solarbits/wsp-solar2020/docs/photos/wotton-swimming-pool.jpg

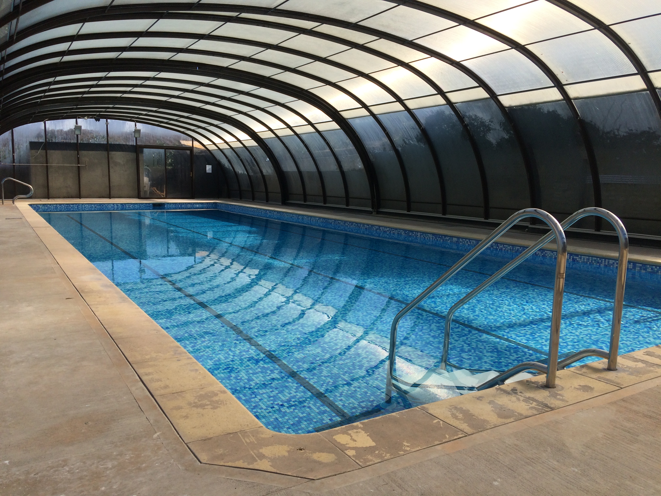
docs/photos/wotton-swimming-pool.jpg
