solarbits/wsp-solar2020/docs/photos/pumps-and-valves-layout.jpg

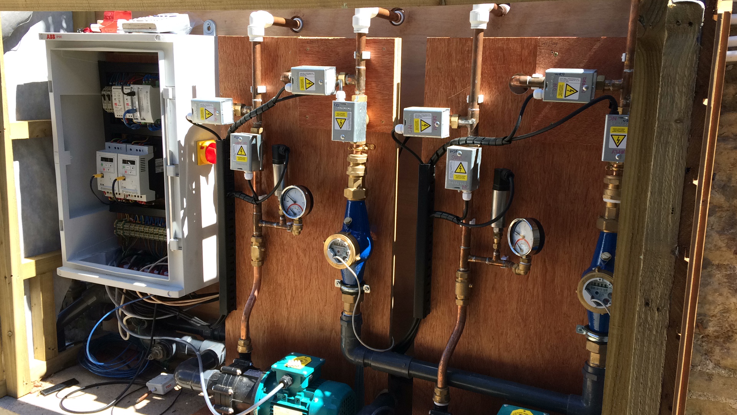
docs/photos/pumps-and-valves-layout.jpg
