solarbits/wsp-solar2020/node-red/README.md

# Node-RED flows

Flow exports for the remote monitoring dashboard. Import them through the
Node-RED editor (Menu → Import). They are exports, not a deployed
configuration — the running instance is the source of truth.

FLows and deployment details for node red are now version controlled at: https://github.com/errkk/wsp-node-red

| File | Notes |
| --- | --- |
| `2021-03-03_dashboard-flow.json` | Full dashboard: MQTT input, JSON parsing, routing by `zone`/`index`, charts, gauges and Pushover alerts (87 nodes). |
| `2021-01-03_chart-node-export.json` | Partial export — a single east-panel temperature chart node. Superseded by the file above. |

## Wire format

The PLC publishes each value individually to topic `IP65`:

```json
{ "zone": 0, "index": 4, "value": 285 }
```

`zone` selects the kind of reading and `index` selects which one within that
kind, matching the `INDEX_*` constants in the sketch.

| zone | Contents | Units |
| ---- | --- | --- |
| 0 | Sensor readings (9) | temperatures in tenths of °C, pressures in millibars |
| 1 | Pump states (2) | 0 = off, 1 = on |
| 2 | Roof states (2) | 0 low pressure, 1 pool too hot, 2 cool roof, 3 heat pool, 4 await sunshine |
| 3 | Roof powers (2) | decawatts |
| 4 | *Not published* | Was chemistry (0 = pH ×100, 1 = chlorine in hundredths of ppm). The PLC no longer sends it: chemistry is read directly from the doser by node red over modbus TCP over a VPN. So this part of the payload could be repurposed. |
| 5 | Flow rates (2) | 0 = west panel, 1 = east panel, in tenths of a litre per minute (`200` = 20 L/min). From the flow meters on I0.0/I0.1; 0 when stopped. |

Changing the zone/index numbering or the topic in the sketch breaks these flows.
