solarbits/wsp-solar2020/docs/diagrams/software-architecture_2021-04-28_with-chemistry.pdf

MODBUS MANAGER
Every few 10s of mS read a sensor (or instruct a pump) and increment the counter to the next modbus address, swapping read/write after each population serviced.
Every cycle check whether MQTT is connected ok, and if not reconnect.

Any modbus
responses?
listenForResponse() | Yes

machine loop

every few uS

pop it into the right place in the results array: handleResponseData(addr,value)
(if it was a pressure convert value to integer format first) convert32BitFloatToInt(value)
requestNextRead() and increment address pointer | requestReadFrom(addr,value)
requestNextWrite() and increment address pointer | requestWriteFor(pump1/2, on/off)

DEAL WITH DATA
sensorReadings[0,1,2,3,4,5,6,7,8] Every few seconds look at the data array, decide what needs doing (decisionTree()). Also read pH and chlorine data from two analogue inputs (readChemistry()). Then send the data, the pump state and the roof operational state to Node Red via MQTT

switchWestOff()
switchEastOff()
coolWestRoof()
coolEastRoof()
heatPoolFromWest()
heatPoolFromEast()

Switch pumps on/off (using the write queue) and control the 8 motorised valve relays with

digitalWrite(RelayNo, on/off)

No
