solarbits/wsp-solar2020/docs/photos/electrical-enclosure.jpg

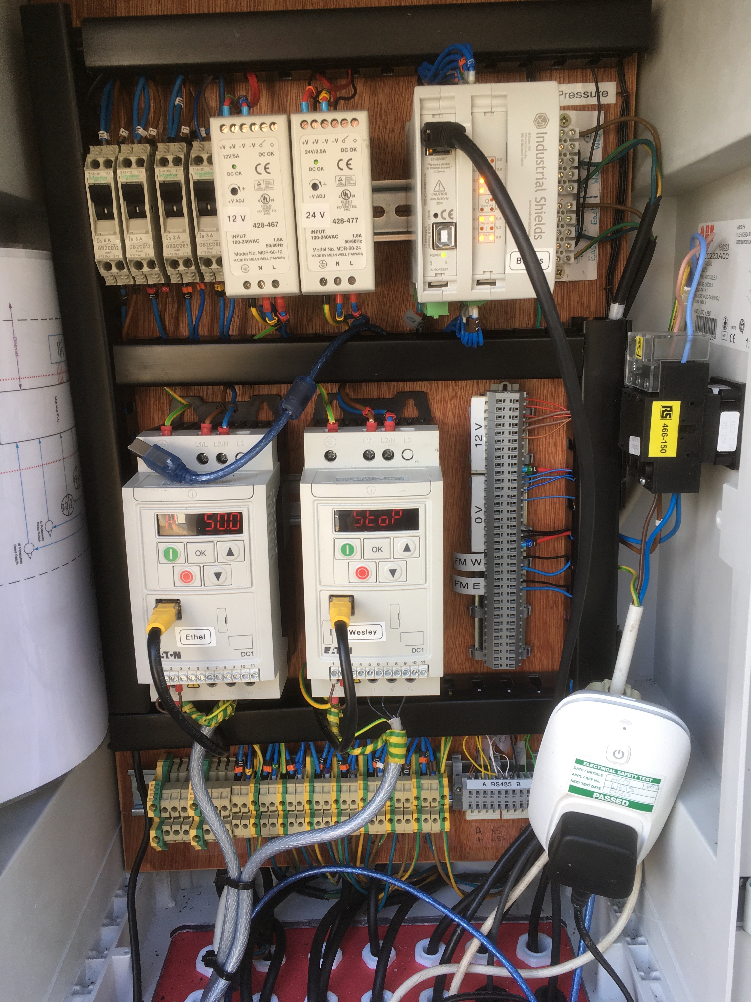
docs/photos/electrical-enclosure.jpg
