solarbits/wsp-solar2020/docs/photos/epdm-pipes-in-roof-cavity.jpg

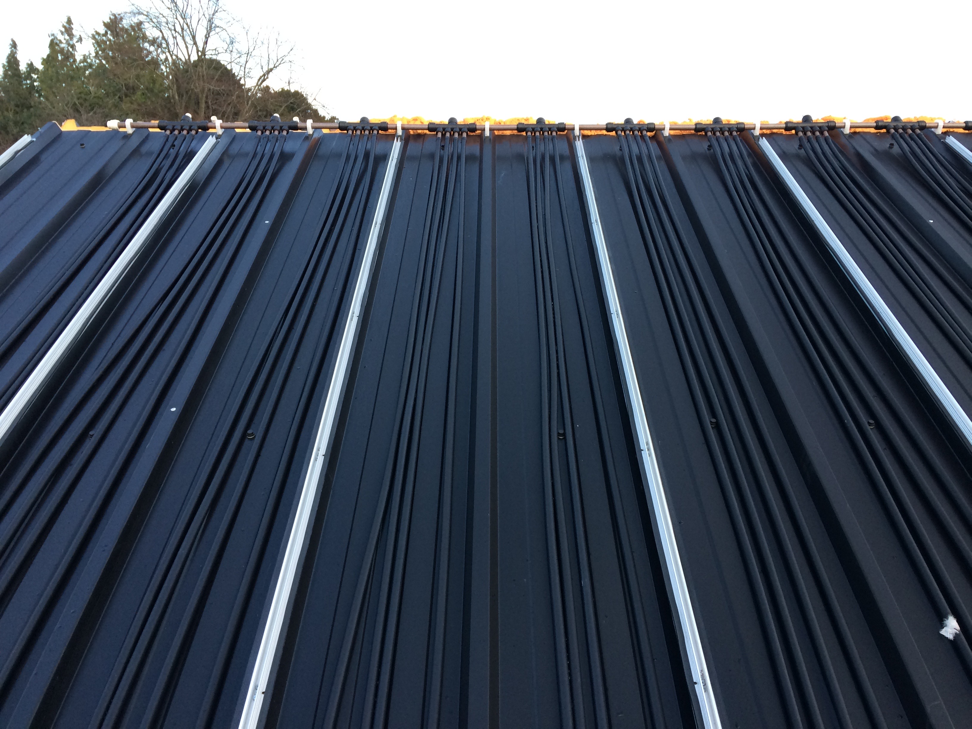
docs/photos/epdm-pipes-in-roof-cavity.jpg
