solarbits/wsp-solar2020/docs/photos/main-enclosure-and-pool-take-off.jpg

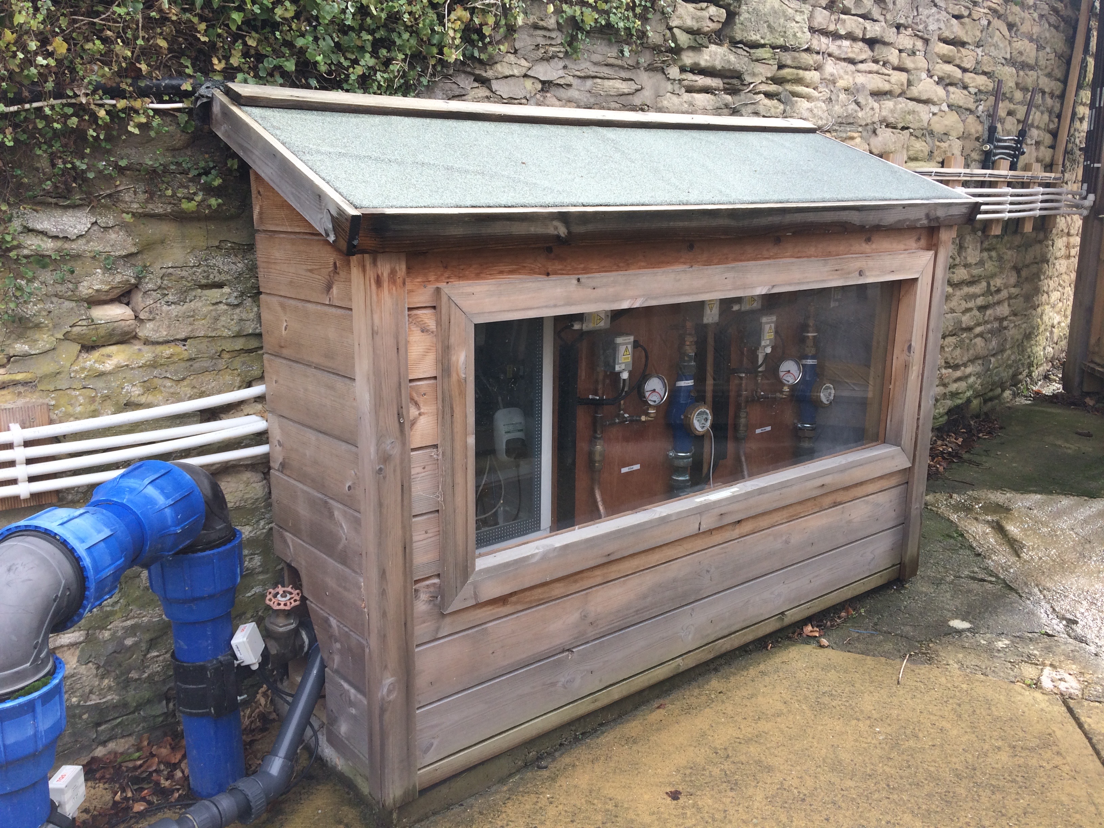
docs/photos/main-enclosure-and-pool-take-off.jpg
