solarbits/wsp-solar2020/docs/photos/manifolds-and-temperature-sensors.jpg

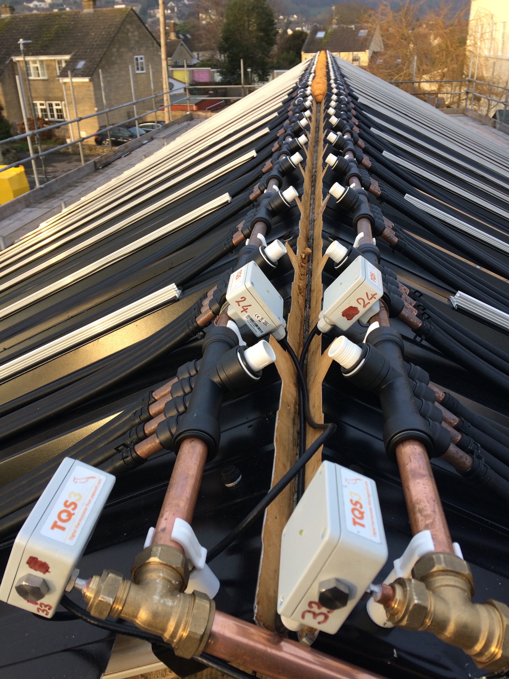
docs/photos/manifolds-and-temperature-sensors.jpg
