solarbits/wsp-solar2020/docs/photos/polycarbonate-roof-covering.jpg

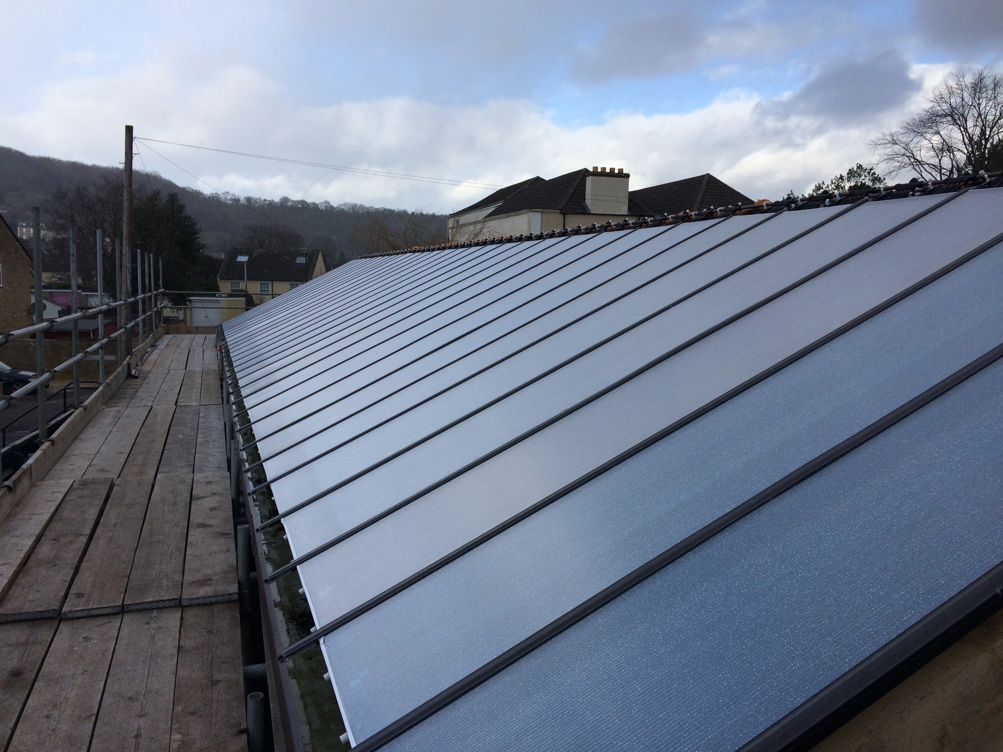
docs/photos/polycarbonate-roof-covering.jpg
