solarbits/wsp-solar2020/docs/diagrams/electrical-diagram_2021-03-07.pdf

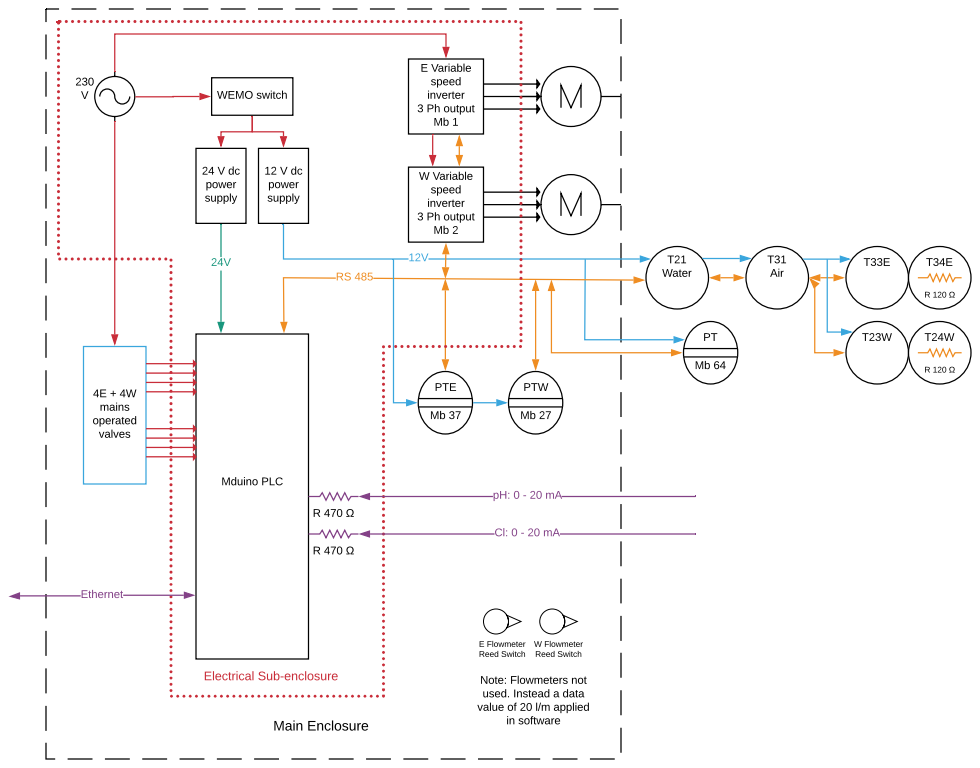
[picture p8: page 1]
12 V dc power supply; E Variable speed inverter 3 Ph output Mb 1; Air; PTE; Mduino PLC; Main Enclosure; 24 V dc power supply; W Variable speed inverter 3 Ph output Mb 2; 4E + 4W mains operated valves; PTW; Water; Ethernet; WEMO switch

E Flowmeter Reed Switch

W Flowmeter Reed Switch

Electrical Sub-enclosure

Note: Flowmeters not
used. Instead a data
value of 20 l/m applied
in software
