solarbits/wsp-solar2020/docs/diagrams/decision-tree-flow-chart_2020-10-20.pdf

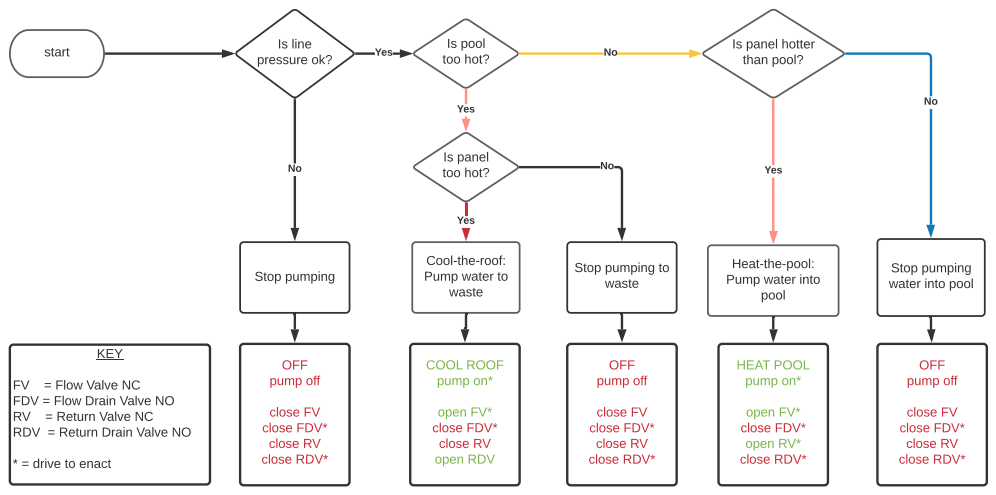
[picture p9: page 1]
Is pool too hot?; Is panel too hot?; Yes; start; Is line pressure ok?; Stop pumping; OFF pump off; close FV close FDV* close RV close RDV*; COOL ROOF pump on*; open FV* close FDV* close RV open RDV; HEAT POOL pump on*; open FV* close FDV* open RV* close RDV*; KEY

Is panel hotter
than pool?

Cool-the-roof:
Pump water to
waste

Stop pumping to

Heat-the-pool:
Pump water into
pool

Stop pumping
water into pool

FV = Flow Valve NC
FDV = Flow Drain Valve NO
RV = Return Valve NC
RDV = Return Drain Valve NO

* = drive to enact
