solarbits/wsp-solar2020/docs/diagrams/panels-and-flow-circuit.pdf

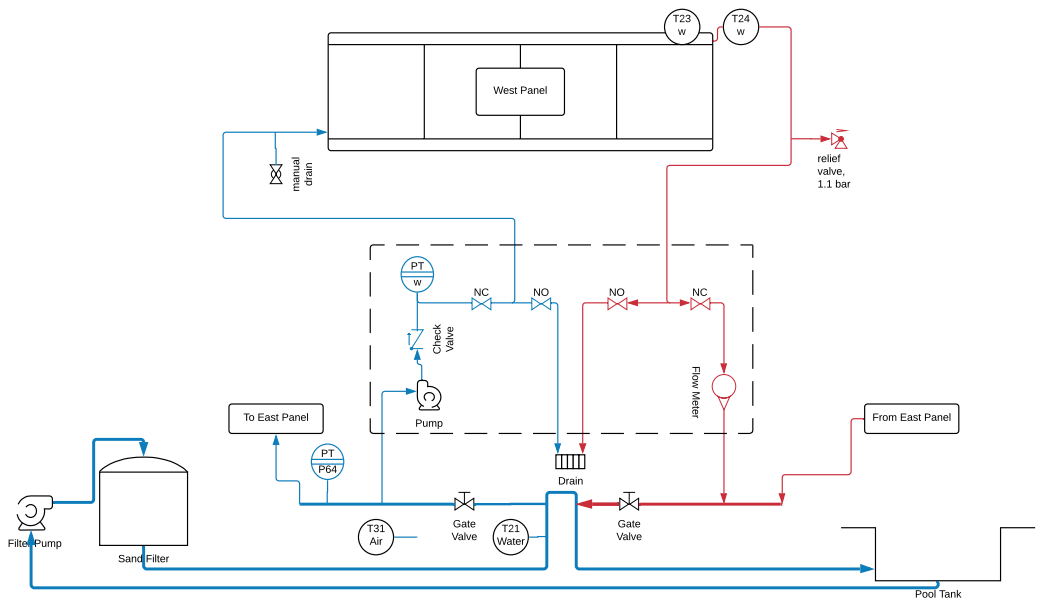
[picture p10: page 1]
Pool Tank; Filter Pump; T31 Air; Gate Valve; Pump; Sand Filter; Check; Valve; Drain; Flow; Meter; West Panel; manual; drain; relief valve, 1.1 bar; T21 Water

To East Panel

From East Panel
