solarbits/wsp-solar2020/(commit log)

2020-11-19 conditional debugs, write sensor data to array just like pump states are written from, manage read/write mode more clearly
2020-11-19 print out all 8 sensors
2020-11-27 convertion code into a function. Use switch to catch multiple addresses for converting
2020-12-10 flow chart of operational code
2020-12-13 reads 2 temps, 3PTs & writes to 2 Inverters
    Successfully reads the sensors and can switch the inverters on based on temp difference to an coded-in pool temp (23C). Needs pressure on the system pressure transducer otherwise everything switched off. Has diagnostics on the Serial Monitor showing data in the results array and a dot for each time it has completed a run through the modbus manager (9 reads, and 2 writes).
2020-12-31 Reads sensor data and broadcasts data & action
    Reads (2) temperatures and (3) pressures. Decides what to do and drives two pumps (via inverters). Broadcasts data to MQTT every few seconds where it is picked up by Node Red. Broadcast includes the sensor data, whether each pump is on/off and the operational state of the roof
2021-01-04 4th Jan 2021 version
    Reads (2) temperatures and (3) pressures. Decides what to do and drives two pumps (via inverters). Broadcasts data to MQTT every few seconds where it is picked up by Node Red. Broadcast includes the sensor data, whether each pump is on/off, the operational state of the roof and the power being collected
2021-01-05 Electrical enclosure: photo
2021-01-05 Main system enclosure & pool water take-off: photo
2021-01-05 Pumps & valves layout: photo
2021-01-22 Working on 21/1/21
    Uses a remote broker (that occasionally needs its firewall enabled due to dynamic IP address changes). Also now has a data trap to skip spurious data
    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
2021-01-22 Add files via upload
    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
2021-03-30 manifolds and temperature sensors
2021-04-28 Includes chemistry readings
    This April 2021 version includes code for collecting data from the 0-20 mA outputs from the doser equipment in the pump room that shows the measured concentrations of chlorine and pH
2024-11-03 update broker address and add auth
    [sketch_mar7a_field.ino]
2025-01-27 Dec2024: New MQTT broker – uploaded
    This version was adapted to use new MQTT broker and reduce trip pressure on the solar pump inlets to 20 mb (from 35 mb)
    [sketch_mar7a_field_dec2024.ino]
2026-03-12 note about ethernet and power
2026-10-13 Average system pressure over 3 seconds
    Store a 3 second moving average in sensorReadings[INDEX_PRES_SYSTEM]
    instead of the instantaneous reading, so the low pressure check, serial
    printout and MQTT value all use the averaged figure.
2026-10-14 Add hysteresis to the pump switching limits
    Every limit in decisionTree() switched on and off at the same value, so
    readings sitting near a limit cycled the pumps every 5 seconds. Each
    limit now has a separate on and off value based on the roof's current
    state:
    - heat pool: start at panel 4C above pool, stop at 1.5C (was 0.5C both)
    - pool too hot: stop above 30C, resume below 29.5C
    - cool roof: start above 60C, stop below 55C
    - low pressure: trip below 35mb, restart above 45mb
    The low pressure check still runs first and trips immediately.
2026-10-16 Revise after review: keep heating thresholds, 10s pressure averaging
    Following the review on the PR:
    - heat pool and pool too hot go back to their original single
    thresholds (0.5C and 30C). With an idle panel the sensor sits in air,
    so a higher start threshold would rarely trigger, and waiting for the
    pool to cool 0.5C wastes too much stored heat
    - roof cooling keeps its hysteresis: start above 60C, stop below 55C
    - low pressure restarts above 40mb (was 45mb in the first version)
    - system pressure is averaged over 10s instead of 3s to calm the noise
    near the trip point, with the sample buffer grown from 8 to 16
2026-10-18 Design proposal: flow meters on the west and east panels
    For review before implementation.
2026-10-18 Add west and east flow meters on I0.0 and I0.1
    Count a pulse every 10 litres on each panel's flow meter using the
    hardware interrupts, work out the flow rate in tenths of L/min, and
    publish it as MQTT zone 5 (index 0 west, 1 east), as set out in
    docs/design/flow-meters.md.
    A pulse only counts when the switch closes after being open for at
    least 200 ms, so bounce is ignored and a meter that stops with its
    switch closed is not counted again. No pulse for 5 minutes reads 0.
